othermod/PSPi-Zero-Version-5/PCB Files/1.0/BOM.csv

ID | Name | Designator | Footprint | Quantity | Manufacturer Part | Manufacturer | Supplier | Supplier Part | Price
1 | 1.8K | R14,R30,R27,R16 | R0603 | 4 | 0603WAF1801T5E | UniOhm | LCSC | C4177 | 0.001
2 | 5.76 | R21,R37,R26 | R0805 | 3 | 0805W8F576KT5E | Uniroyal Elec | LCSC | C247078 | 0.003
3 | SI2302 | Q2,Q11,Q10,Q7,Q8,Q3 | SOT-23-3_L2.9-W1.3-P1.90-LS2.4-BR | 6 | SI2302 | Hottech | LCSC | C181087 | 0.025
4 | B5819W_C8598 | D2 | SOD-123_L2.8-W1.8-LS3.7-RD | 1 | B5819W | CJ | LCSC | C8598 | 0.043
5 | MP3302DJ-LF-Z | U8 | SOT-23-5_L3.0-W1.7-P0.95-LS2.8-BR | 1 | MP3302DJ-LF-Z | MPS | LCSC | C15035
6 | 1uF | C7,C32,C31,C26,C27,C1,C6,C28,C30,C40 | C0603 | 10 | CL10A105KB8NNNC | SAMSUNG | LCSC | C15849 | 0.007
7 | 10uF | C9,C39,C41,C42,C5,C10,C8,C24,C33,C34,C13,C4 | C0603 | 12 | CL10A106KP8NNNC | SAMSUNG | LCSC | C19702 | 0.009
8 | 100K | R25,R36,R33,R8,R10,R2,R11 | R0603 | 7 | 0603WAF1003T5E | UniOhm | LCSC | C25803 | 0.001
9 | 22uH | L7 | IND-SMD_L4.4-W4.2 | 1 | MWSA0402S-220MT | Sunlord | LCSC | C408340 | 0.172
10 | SM06B-SRSS-TB(LF)(SN) | U4 | CONN-SMD_SM06B-SRSS-TB-LF-SN | 1 | SM06B-SRSS-TB(LF)(SN) | JST Sales America | LCSC | C160405 | 0.196
11 | B2B-PH-SM4-TB (LF)(SN) | CN4 | CONN-SMD_B2B-PH-SM4-TB-LF-SN | 1 | - | JST Sales America | LCSC | C160352 | 0.148
12 | 100uF | C11,C38 | C1206 | 2 | CL31A107MQHNNNE | SAMSUNG | LCSC | C15008 | 0.116
13 | BM02B-SURS-TF(LF)(SN) | CN1,CN6 | CONN-SMD_2P-P0.80_BM02B-SURS-TF-LF-SN | 2 | BM02B-SURS-TF(LF)(SN) | JST Sales America | LCSC | C385130 | 0.218
14 | MSK12C02-HB | SW1 | SW-TH_MSK12C02-HB | 1 | MSK12C02-HB | SHOU HAN | LCSC | C431541 | 0.052
15 | TF-115 | CARD1 | TF-SMD_TF-115 | 1 | TF-115 | XUNPU | LCSC | C266620 | 0.176
16 | Pi Zero With Pads | G$1 | RASPBERRY_PI_ZERO_WITH_PADS | 1
17 | PSPi | U19 | PSPI_OUTLINE | 1
18 | 10K | R7,R9,R22,R32,R28,R31,R1,R13 | R0603 | 8 | 0603WAF1002T5E | UniOhm | LCSC | C25804 | 0.001
19 | BCM856BS,115 | Q6 | SOT-363_L2.0-W1.3-P0.65-LS2.1-BL | 1 | BCM856BS,115 | Nexperia | LCSC | C456122 | 0.149
20 | TP4056 | U11 | ESOP-8_L4.9-W3.9-P1.27-LS6.0-BL-EP | 1 | TP4056 | TOPPOWER | LCSC | C16581 | 0.209
21 | NC7WZ17P6X | U3 | SOT-363_L2.0-W1.3-P0.65-LS2.1-BR | 1 | NC7WZ17P6X | FAIRCHILD | LCSC | C81546 | 0.085
22 | AFC42-S40FMA-1H | FPC9 | CONN-SMD_40P-P0.50_L3.1-W22.0 | 1 | AFC42-S40FMA-1H | JUSHUO | LCSC | C466536 | 0.255
23 | 300K | R4,R3,R35,R12 | R0603 | 4 | 0603WAF3003T5E | UniOhm | LCSC | C23024 | 0.001
24 | BD4830G-TR | U15 | SSOP-5_L3.0-W1.6-P0.95-LS2.8-BL | 1 | BD4830G-TR | ROHM Semicon | LCSC | C507475 | 0.163
25 | 18K | R17 | R0603 | 1 | 0603WAF1802T5E | UniOhm | LCSC | C25810 | 0.002
26 | 100nF | C35,C3,C17,C18,C19,C20,C21,C25 | C0603 | 8 | CC0603KRX7R9BB104 | YAGEO | LCSC | C14663 | 0.003
27 | 2.2uH | L1 | IND-SMD_L3.0-W3.0 | 1 | SWPA3015S2R2MT | Sunlord | LCSC | C43389 | 0.042
28 | SI2301CDS-T1-GE3 | Q1,Q4,Q5 | SOT-23-3_L3.0-W1.7-P0.95-LS2.9-BR | 3 | SI2301CDS-T1-GE3 | VISHAY | LCSC | C10487 | 0.119
29 | 0.1 | R19,R18,R23 | R1206 | 3 | 1206W4F100LT5E | UniOhm | LCSC | C25334 | 0.009
30 | AFC05-S24FIA-00 | FPC6 | FPC-SMD_AFC05-S24FIA-00 | 1 | AFC05-S24FIA-00 | JUSHUO | LCSC | C561390 | 0.165
31 | AFC05-S10FIA-00 | FPC5 | FPC-SMD_AFC05-S10FIA-00 | 1 | AFC05-S10FIA-00 | JUSHUO | LCSC | C561386 | 0.133
32 | SN74LVC1G07DBVR | U2,U7,U17 | SOT-23-5_L3.0-W1.7-P0.95-LS2.8-BR | 3 | SN74LVC1G07DBVR | TI | LCSC | C7829 | 0.056
33 | SGM2019-2.5YN5G/TR | U20 | SOT-23-5_L3.0-W1.7-P0.95-LS2.8-BR | 1 | SGM2019-2.5YN5G/TR | SGMICRO | LCSC | C46572
34 | ATMEGA328P-AU | U1 | TQFP-32_L7.0-W7.0-P0.80-LS9.0-BL | 1 | ATMEGA328P-AU | MICROCHIP | LCSC | C14877 | 4.031
35 | 10nF | C37 | C0603 | 1 | 0603B103K500NT | FH | LCSC | C57112 | 0.003
36 | 1.2K | R5,R24 | R0603 | 2 | 0603WAF1201T5E | UniOhm | LCSC | C22765 | 0.001
37 | 220pF | C2,C12,C14,C15,C16 | C0603 | 5 | CL10B221KB8NNNC | SAMSUNG | LCSC | C1603 | 0.006
38 | 100uH | L3,L4,L5,L6 | L0805 | 4 | MLF2012C101KT000 | TDK | LCSC | C68035 | 0.038
39 | 47uF | C29,C22 | C1206 | 2 | CL31A476MPHNNNE | SAMSUNG | LCSC | C96123 | 0.104
40 | 220 | R6,R20 | R0603 | 2 | 0603WAF2200T5E | UniOhm | LCSC | C22962 | 0.001
41 | 100 | R15,R29 | R0603 | 2 | 0603WAF1000T5E | UniOhm | LCSC | C22775 | 0.001
42 | PAM8407DR | U14 | SOIC-16_L9.9-W3.9-P1.27-LS6.0-BL | 1 | PAM8407DR | DIODES | LCSC | C177141 | 0.826
43 | 19-217/GHC-YR1S2/3T | LED1 | LED0603-R-RD | 1 | 19-217/GHC-YR1S2/3T | EVERLIGHT | LCSC | C72043 | 0.025
44 | BAT54C,215 | D3 | SOT-23-3_L2.9-W1.6-P1.90-LS2.8-BR | 1 | BAT54C,215 | Nexperia | LCSC | C37704 | 0.016
45 | TPS63020DSJR | U5 | VSON-14_L4.0-W3.0-P0.50-BL | 1 | TPS63020DSJR | TI | LCSC | C15483 | 2.685
