othermod/PSPi-Zero-Version-5/(threads)

Thread 1 (2022-07-23):

BOM for gerber files - out of stock items

carjufi, 2022-07-23:
Hi, thanks for sharing the gerber files to order the PCBs. My plan is to order the PCBs and solder the components myself but, there are some items that are out of stock (as lately everything is) or discontinued and I was wondering if you could share the schematics and PCB files so that I can try to replace them for equivalent ones and complete the project. I have easyEDA account which I think you used to generate the gerber files. Let me know if you could do this, it would help me a lot.

Also, on a different note, the gerber files contain the "PSPi Zero board" but not the "PSPi headphone board", is this wrong? I guess the headphone board is not essential, but I would like to complete the project with all boards in it.

Thanks!
