othermod/PSPi-Zero-Version-5/config.txt

#dtoverlay=pi3-disable-bt
#dtoverlay=pi3-disable-wifi

disable_splash=1

dtparam=i2c_arm=on

# Enable audio (loads snd_bcm2835)
dtparam=audio=on
disable_audio_dither=1
audio_pwm_mode=2

# HDMI
hdmi_drive=1
hdmi_ignore_edid_audio=1
hdmi_blanking=2

[all]
#dtoverlay=vc4-fkms-v3d
gpu_mem_256=128
gpu_mem_512=256
gpu_mem_1024=256
overscan_scale=1

#Set GPIO pins to 18-Bit DPI Mode 6
#GPIO 0 and 1 needed for DPI Clock and Data Enable
gpio=0=a2,np
gpio=1=a2,np
#Set GPIO pins 2 and 3 to I2C Mode. These can be used for other things, if needed.
gpio=2=a0,np
gpio=3=a0,np
#Set up color pins
gpio=4=a2,np
gpio=5=a2,np
gpio=6=a2,np
gpio=7=a2,np
gpio=8=a2,np
gpio=9=a2,np
#GPIO 10 is available for use
dtoverlay=gpio-shutdown,gpio_pin=10,debounce=250
#GPIO 11 is the Hold switch
gpio=11=ip,pu
gpio=12=a2,np
gpio=13=a2,np
gpio=14=a2,np
gpio=15=a2,np
gpio=16=a2,np
gpio=17=a2,np
dtoverlay=pwm-2chan,pin=18,func=2,pin2=19,func2=2
gpio=20=a2,np
gpio=21=a2,np
gpio=22=a2,np
gpio=23=a2,np
gpio=24=a2,np
gpio=25=a2,np
#GPIO 26 powers the board off after shutdown
gpio=26=ip,pu
dtoverlay=gpio-poweroff,active_low="y"
#GPIO 27 is the activity LED
dtparam=act_led_gpio=27
dtparam=act_led_activelow=yes

include lcd.txt
