othermod/PSPi-Zero-Version-5/(commit log)

2021-01-09 adding the ATMega328P driver for the PSPi controller
2021-01-10 write ATmega328P fuses
2021-01-14 add config.txt
    [config.txt]
2021-01-19 configured DPI on CM4, moved ATmega328p from I2C-0 to I2C-1 due to issues with i2c0 overlay
    [config.txt]
2021-02-12 removed SPI code, will add to setup script
2021-06-08 add battery images
2021-06-08 add newest driver and firmware, shuffle things around
2021-06-09 more changes to driver
2021-06-10 updated controller driver and firmware
2021-06-12 more shuffling, updated driver and firmware
    [PSPi Controller.cfg, config.txt, es_input.cfg, retroarch.cfg]
2021-06-17 added mute indication to driver
2021-06-17 changed starting battery image
2021-06-19 Cleaned up the code. Combined multiple checks of Mute and Display buttons into single check
2021-06-21 edit config
    [es_settings.cfg, retroarch.cfg]
2021-06-24 added ability to send data to change the LCD brightness, LED color, and mute status on the ATmega
2021-06-24 added missing battery indicator
2021-06-29 adjust emulationstation config
    [es_input.cfg, es_settings.cfg]
2021-07-06 fix low battery indicator LED
    [Firmware.ino]
2021-07-08 add modified Carbon theme
    [es_systems.cfg]
2021-07-09 disable splash screen
    [config.txt]
2021-07-09 update driver
2021-07-10 added automatic i2c config
2021-07-22 add PCB files
    [BOM.csv, PickAndPlace.csv]
2021-07-22 added correct gerber file
2021-07-27 add config.txt for 480x272 LCD
    [config.txt]
2021-07-27 moved config.txt file and updated instructions
    [config.txt]
2021-07-27 moved config.txt
    [config.txt]
2021-07-31 updated driver to make actions more clear in code, and to fix indicator placement on 480x272 LCD
2021-07-31 renamed config folders
    [config.txt]
2021-08-01 fix for driver not starting
2021-08-01 adjust charge detection sensitivity
2021-08-02 adjust charge/discharge detection and hysteresis
2021-08-10 combine the controller driver into a single file
2021-08-15 added "Sleep Mode" to driver in a more proper manner
2021-08-15 add longer debounce to prevent accidental poweroff when leaving "Sleep Mode"
    [config.txt]
2021-08-15 modify config.txt layout
    [config.txt]
2021-08-16 disable blinking standby LED temporarily
2021-08-17 add magnet link
2021-12-16 disable built-in LED on Pi Zero 2 W
2022-01-22 complete rewrite of driver
2022-01-23 change button configs
    [es_input.cfg, retroarch.cfg]
2022-01-23 add -joystick argument to enable joystick. fix typo breaking west button
    [osd.c]
2022-01-23 edit debounce time on shutdown button. add comments
    [config.txt]
2022-01-23 change save state buttons
    [retroarch.cfg]
2022-01-23 create virtual button for hotkey
2022-01-23 update hotkeys to mostly match RetroArch defaults
    [retroarch.cfg]
2022-01-30 add internal battery resistance to voltage calculation
2022-02-01 upload newest driver
2022-02-03 set default audio device in emulationstation
    [es_settings.cfg]
2022-02-04 disable hdmi checks
    [config.txt]
